fprackwieser/technobot/Medien/robot_display.jpg

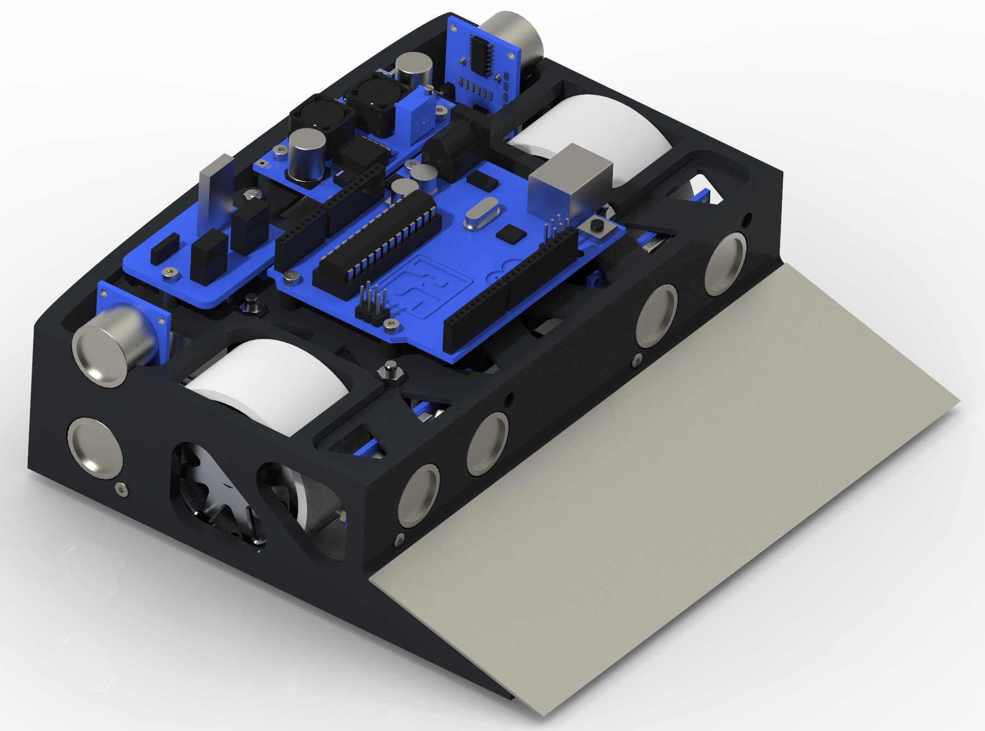
Medien/robot_display.jpg
