fprackwieser/technobot/3D Modelle/ultraschallsensor.3mf

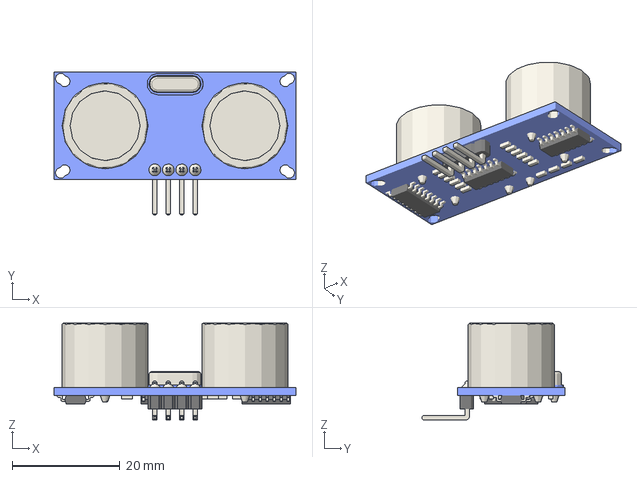
[picture p20: CAD file, 2023-06-07]
3D Modelle/ultraschallsensor.3mf
45.0 x 26.6 x 18.0 mm
