fprackwieser/technobot/Modelle/bn_gjkzgl.stl

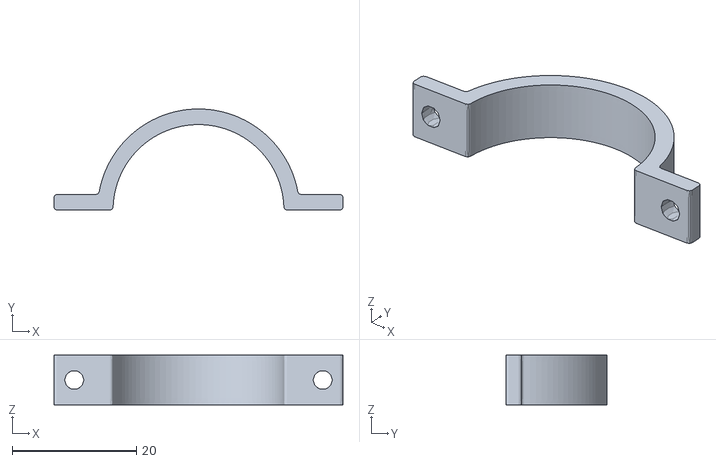
[picture p21: CAD file, 2023-06-07]
Modelle/bn_gjkzgl.stl
46.5 x 16.2 x 8.00
