fprackwieser/technobot/3D Modelle/Abwaertswandler.3mf

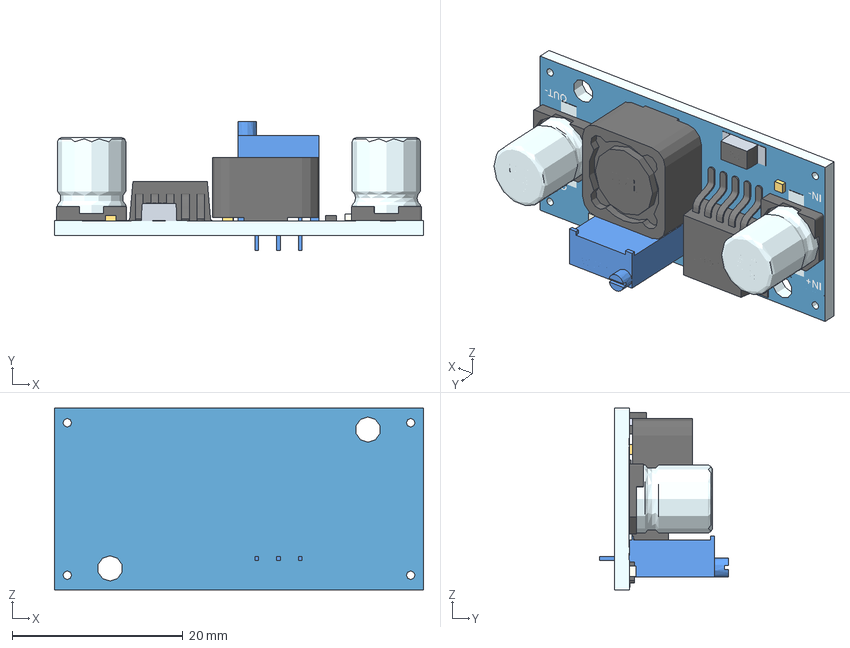
[picture p22: CAD file, 2023-06-07]
3D Modelle/Abwaertswandler.3mf
43.2 x 15.2 x 21.2 mm
NORM_DOWN_CONVERTER_body_0
NORM_DOWN_CONVERTER_body_1
