fprackwieser/technobot/Modelle/3d_print.3mf

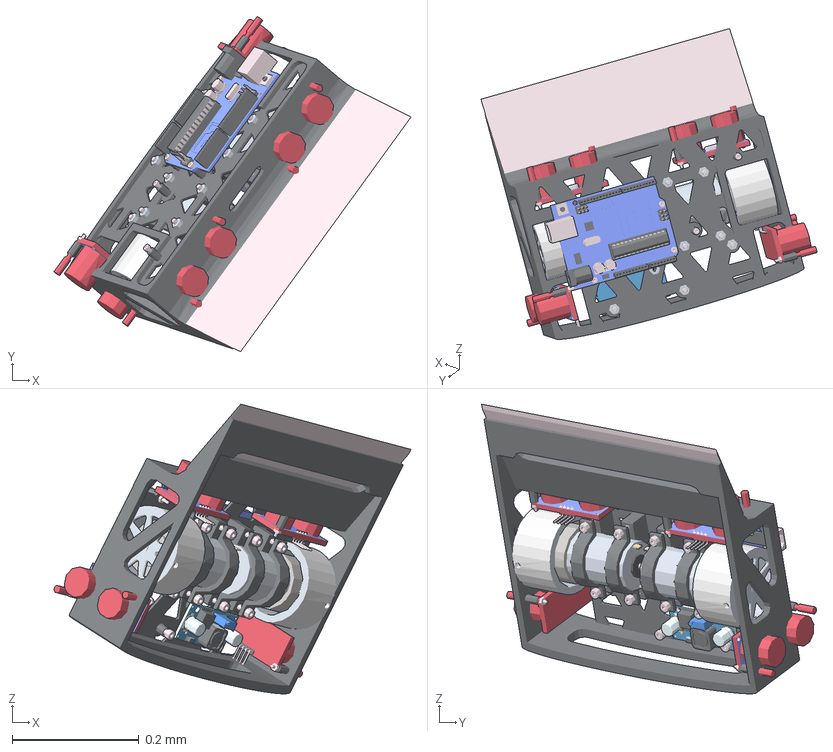
[picture p23: CAD file, 2023-06-07]
Modelle/3d_print.3mf
0.563 x 0.528 x 0.457 mm
