fprackwieser/technobot/3D Modelle/Motor.3mf

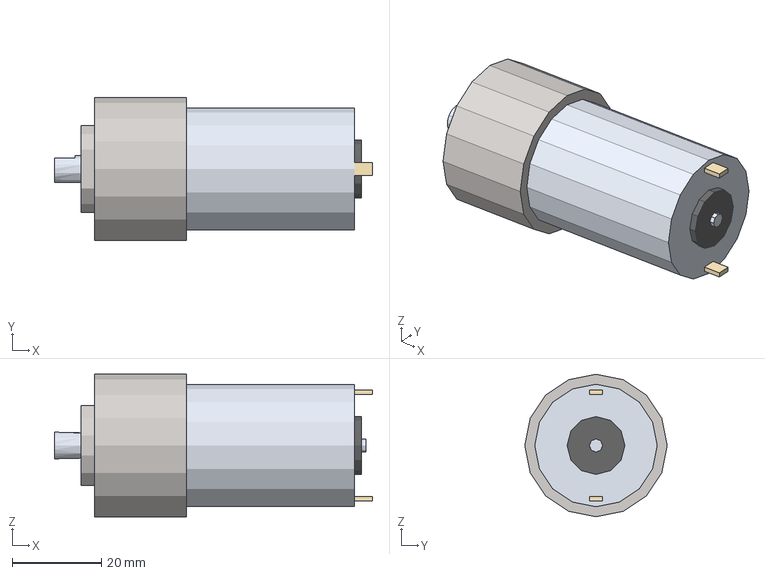
[picture p24: CAD file, 2023-06-07]
3D Modelle/Motor.3mf
71.4 x 32.0 x 32.0 mm
