fprackwieser/technobot/3D Modelle/Spannungswandler.3mf

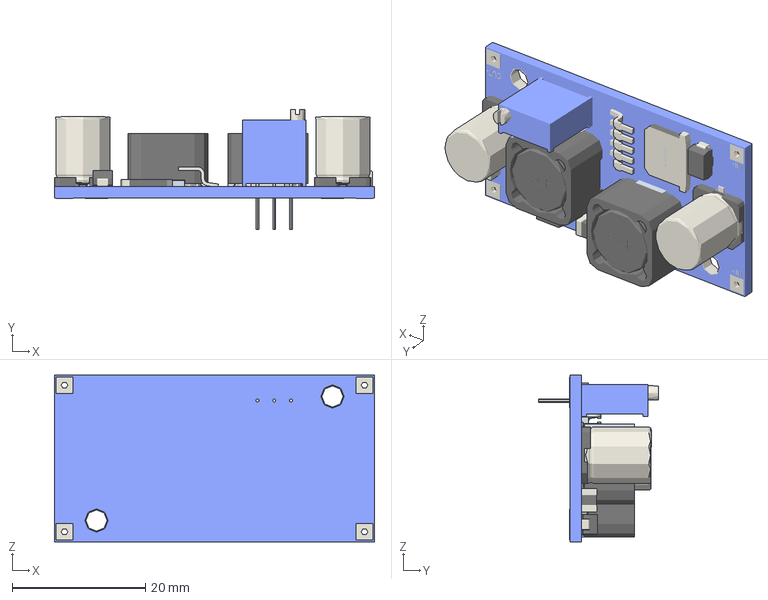
[picture p25: CAD file, 2023-06-07]
3D Modelle/Spannungswandler.3mf
48.0 x 18.0 x 25.0 mm
