fprackwieser/technobot/Modelle/01_schaufel.stl

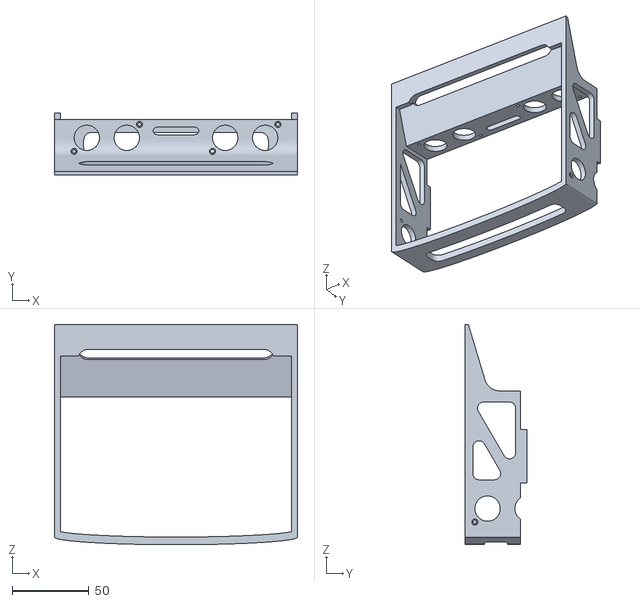
[picture p26: CAD file, 2023-06-07]
Modelle/01_schaufel.stl
158.0 x 40.0 x 143.3
