fprackwieser/technobot/3D Modelle/Motortreiber.3mf

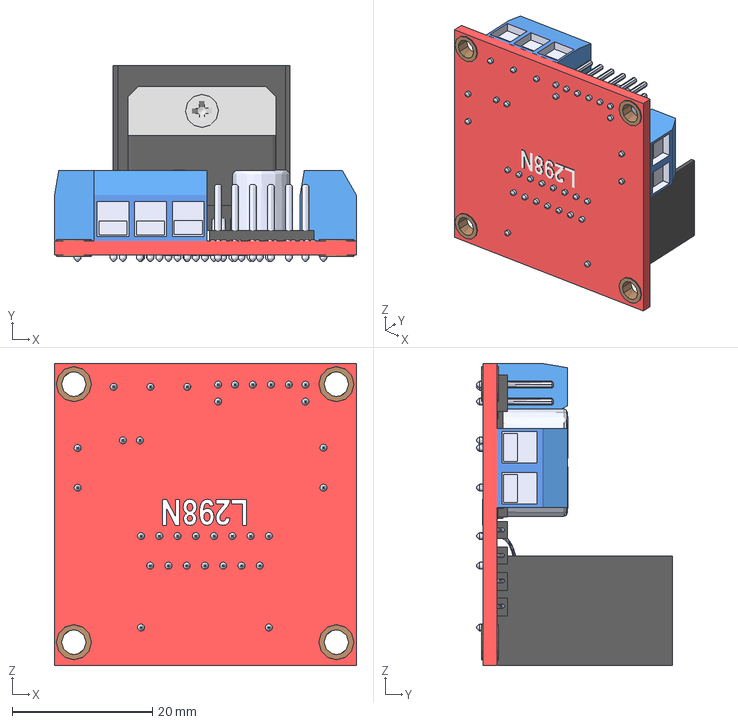
[picture p27: CAD file, 2023-06-07]
3D Modelle/Motortreiber.3mf
43.0 x 28.0 x 43.0 mm
