fprackwieser/technobot/Modelle/02_schelle_unten.stl

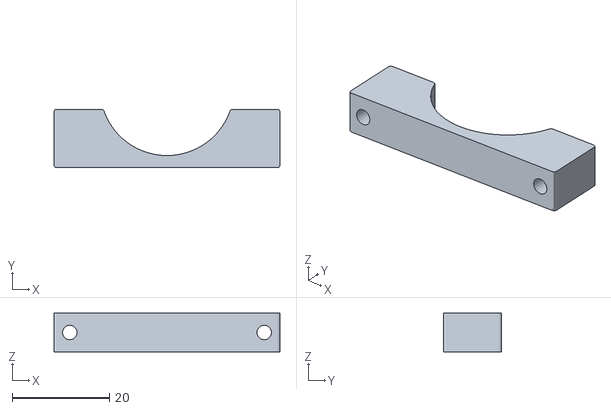
[picture p28: CAD file, 2023-06-07]
Modelle/02_schelle_unten.stl
46.5 x 12.0 x 8.00
