fprackwieser/technobot/3D Modelle/arduino.3mf

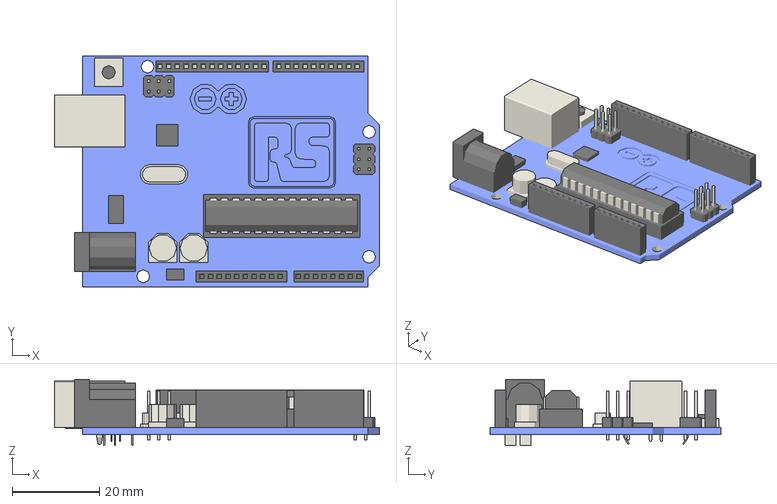
[picture p29: CAD file, 2023-06-07]
3D Modelle/arduino.3mf
74.7 x 53.2 x 15.2 mm
