fprackwieser/technobot/Modelle/prod_deduster_3d_print.3mf

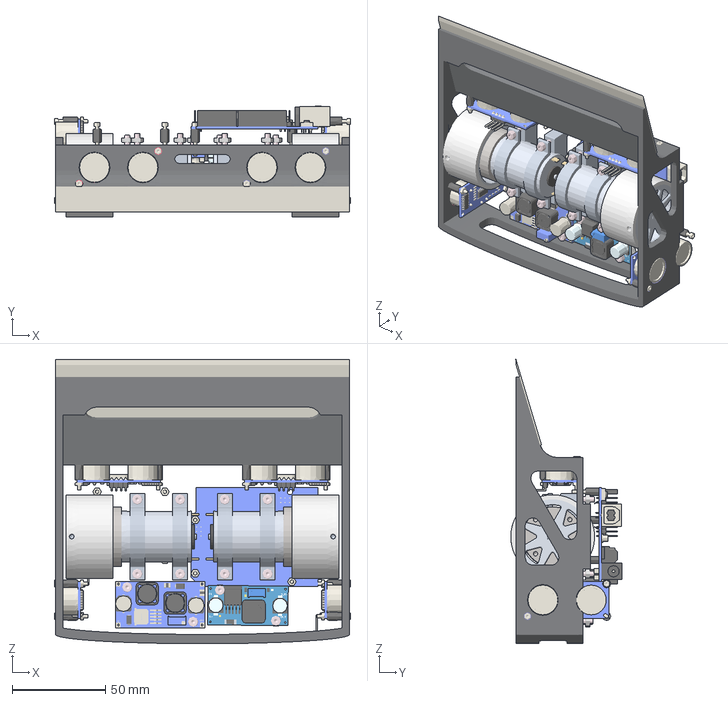
[picture p30: CAD file, 2023-06-07]
Modelle/prod_deduster_3d_print.3mf
159.0 x 59.9 x 152.8 mm
