fprackwieser/technobot/Modelle/zusatz_spacer_m3x5.stl

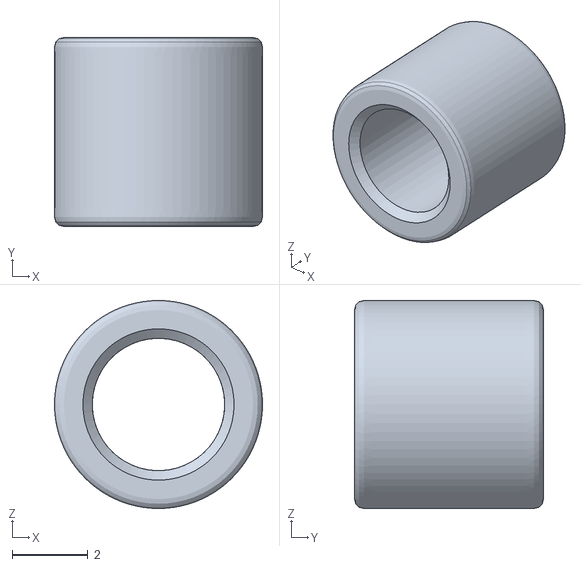
[picture p31: CAD file, 2023-06-07]
Modelle/zusatz_spacer_m3x5.stl
5.50 x 5.00 x 5.50
