fprackwieser/technobot/Modelle/zusatz_spacer_m2x8.stl

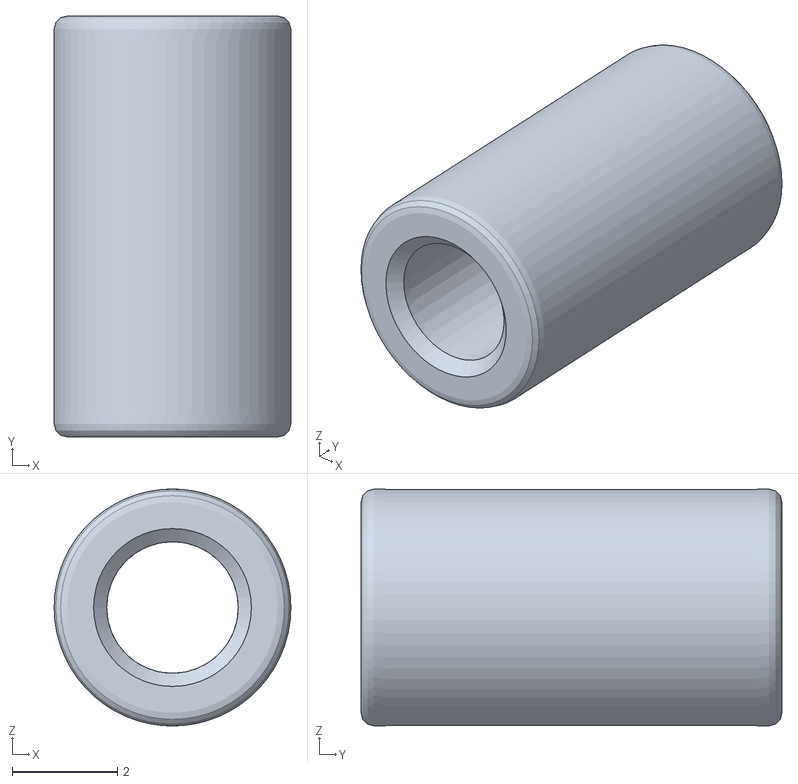
[picture p32: CAD file, 2023-06-07]
Modelle/zusatz_spacer_m2x8.stl
4.50 x 8.00 x 4.50
