fprackwieser/technobot/Modelle/zusatz_spacer_m2x7.stl

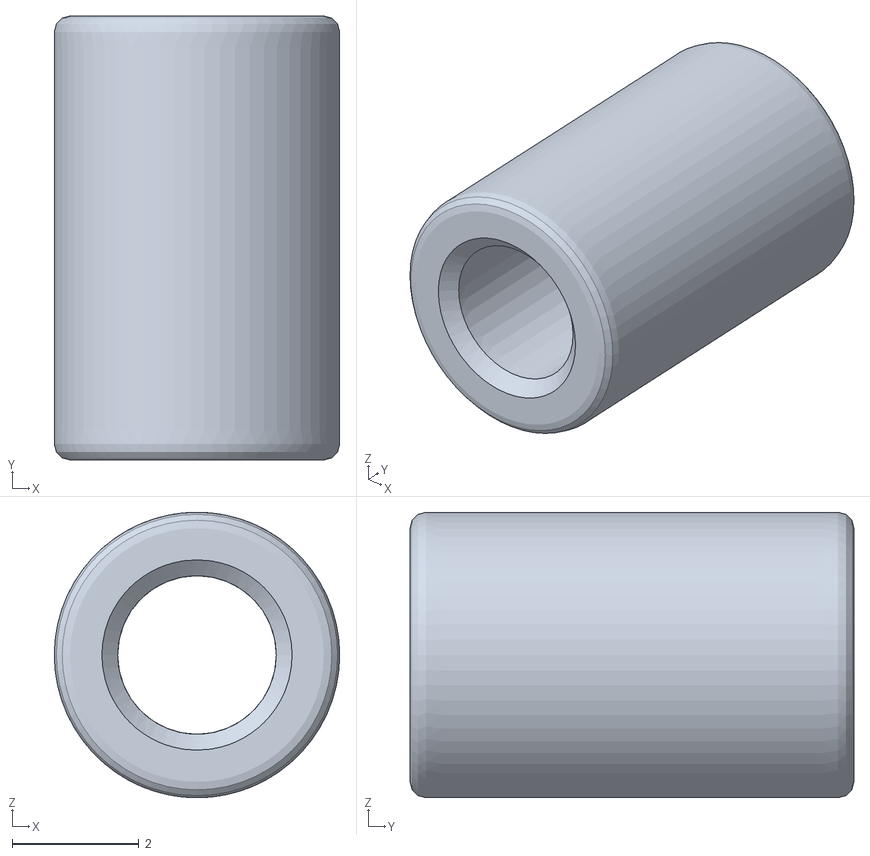
[picture p33: CAD file, 2023-06-07]
Modelle/zusatz_spacer_m2x7.stl
4.50 x 7.00 x 4.50
