fprackwieser/technobot/Modelle/zusatz_spacer_m3x7.stl

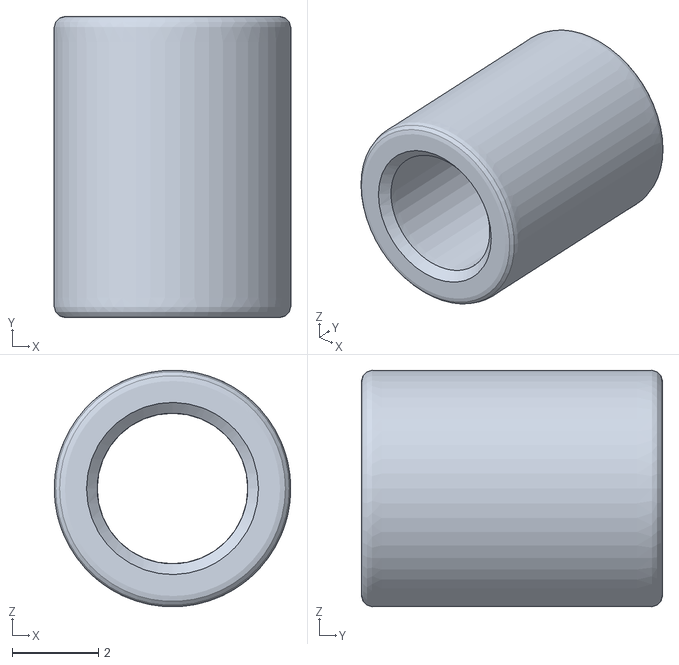
[picture p34: CAD file, 2023-03-07]
Modelle/zusatz_spacer_m3x7.stl
5.50 x 7.00 x 5.50
