fprackwieser/technobot/Modelle/01_grundplatte_15.stl

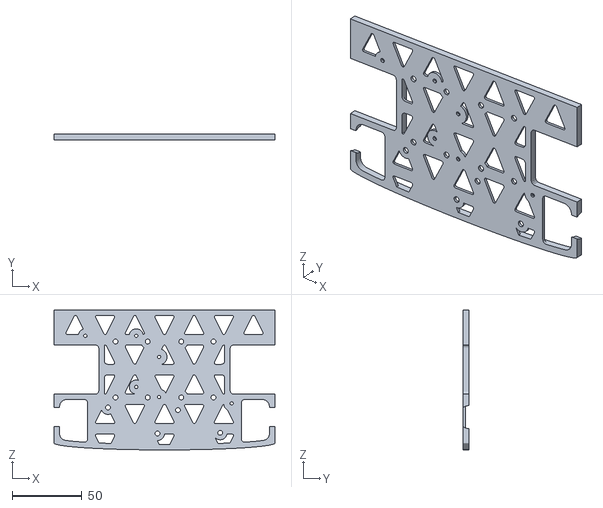
[picture p35: CAD file, 2023-03-07]
Modelle/01_grundplatte_15.stl
158.0 x 4.00 x 100.0
