fprackwieser/technobot/(list of files, cad)

Other CAD files:
Modelle/02_schelle_oben.stl
Modelle/grundplatte.stp
Modelle/schaufel.stp
Modelle/01_grundplatte_15.dwg
Modelle/01_grundplatte_15.dxf
