fprackwieser/technobot/(commit log)

2022-12-21 basis und motor
2023-01-10 neuer motor
2023-01-10 arduino 3d modell
2023-01-10 arduino uno 3d und Ultraschallsensor 3d
2023-01-10 Motorhalterung Groß NEU Erstellt
    Fertig, schrauben ins Modell noch nicht eingebaut
2023-01-10 ultraschall spacer
2023-01-10 CFG Datei für Purger
    [Spekpur.cfg]
2023-01-10 Motorhalterung_Klein
    Untere Schale = Fertig
    Beim großen Halter Abstand zwischen den 2 schalen müssen gemacht werden
2023-01-11 Roboter Arduino Code
2023-01-11 Motorhalterung_Groß = Fertig
2023-01-17 Arduino code
2023-01-17 Neue Dateistruktur und Namensgebug
    [motorhalterung_gro0.stl]
2023-01-17 Motor Baugruppe
2023-01-17 motor.asm render + kleine halterung 2x
2023-01-17 ka was des is
2023-01-20 cnc programm & felge änderungen
    [07_01_felge.dxf]
2023-01-23 purgen und motorbaugruppe auf neue felge abgstimmt
2023-01-31 arduino befestigung
2023-01-31 purge und animation
    [Nut-M2.sldprt]
2023-01-31 arduino_einbau und treiber_einbau
2023-02-01 grundplatte mit arduino
2023-02-07 3dp spacer
    [05_01_ultraschallsensor_spacer_n.stl, 06_02_arduino_spacer.stl, 11_05_treiber_spacer.stl]
2023-02-07 spacer update
2023-03-07 Spacer M2&3 X7
2023-03-07 motor test
2023-03-07 Grundplatte stl
    [01_grundplatte_15.stl, zusatz_spacer_m2x7.stl, zusatz_spacer_m3x7.stl]
2023-03-15 3d-druck Motorhalterung
    [02_schelle_oben.stl, 02_schelle_unten.stl]
2023-04-18 3d Paint Dateien
    [3d_print.3mf]
2023-05-22 3MF 3D Komponente
    [Abwaertswandler.3mf, Motor.3mf, Motortreiber.3mf, Spannungswandler.3mf, arduino.3mf, ultraschallsensor.3mf]
